zeevsklyar6-ai/RoboticArm/Code/Pics/WiringDiagram/Other/WieringModified.png

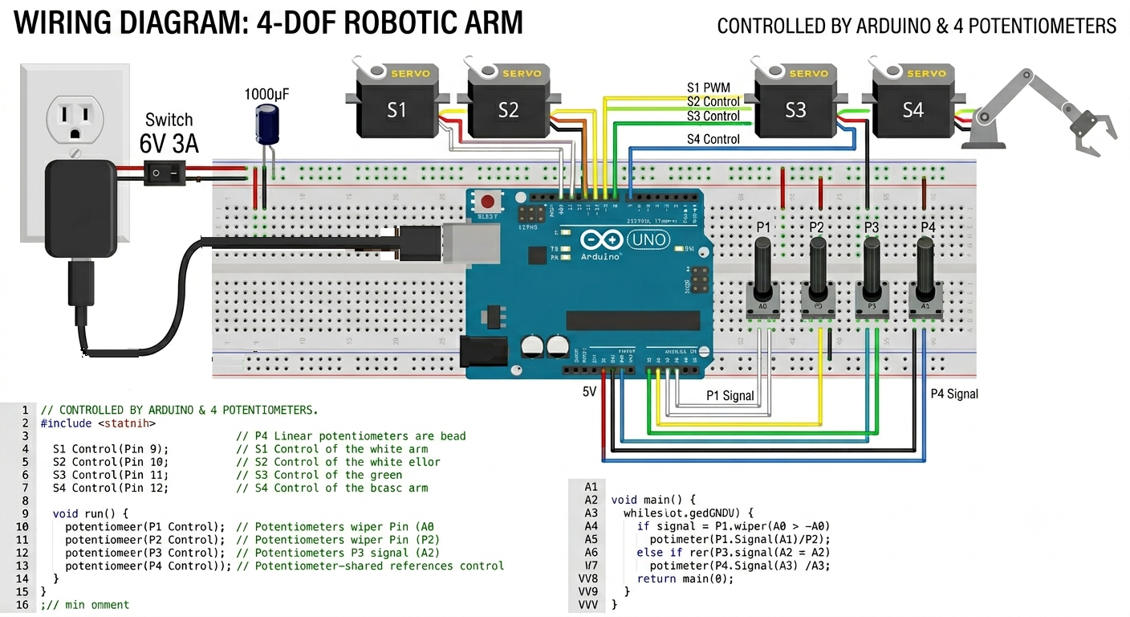
Code/Pics/WiringDiagram/Other/WieringModified.png
