zeevsklyar6-ai/RoboticArm/3dPrinter/V1/RoboticArmV1_1.jpg

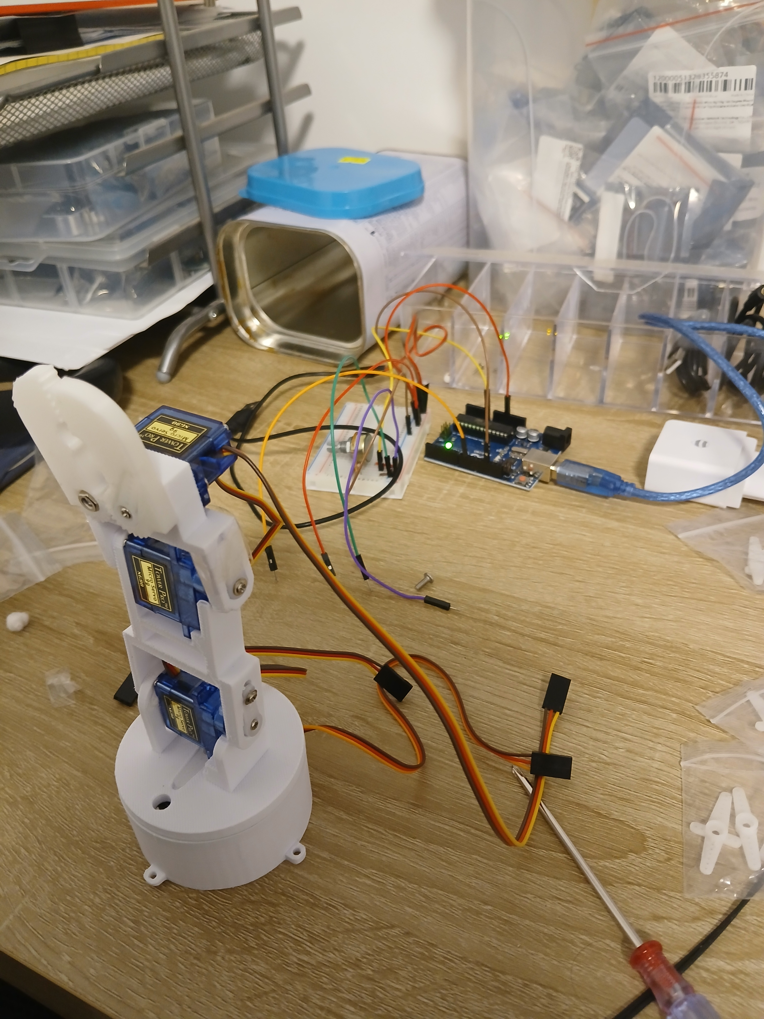
3dPrinter/V1/RoboticArmV1_1.jpg
