zeevsklyar6-ai/RoboticArm/Code/Pics/CamacitorsUsed.jpg

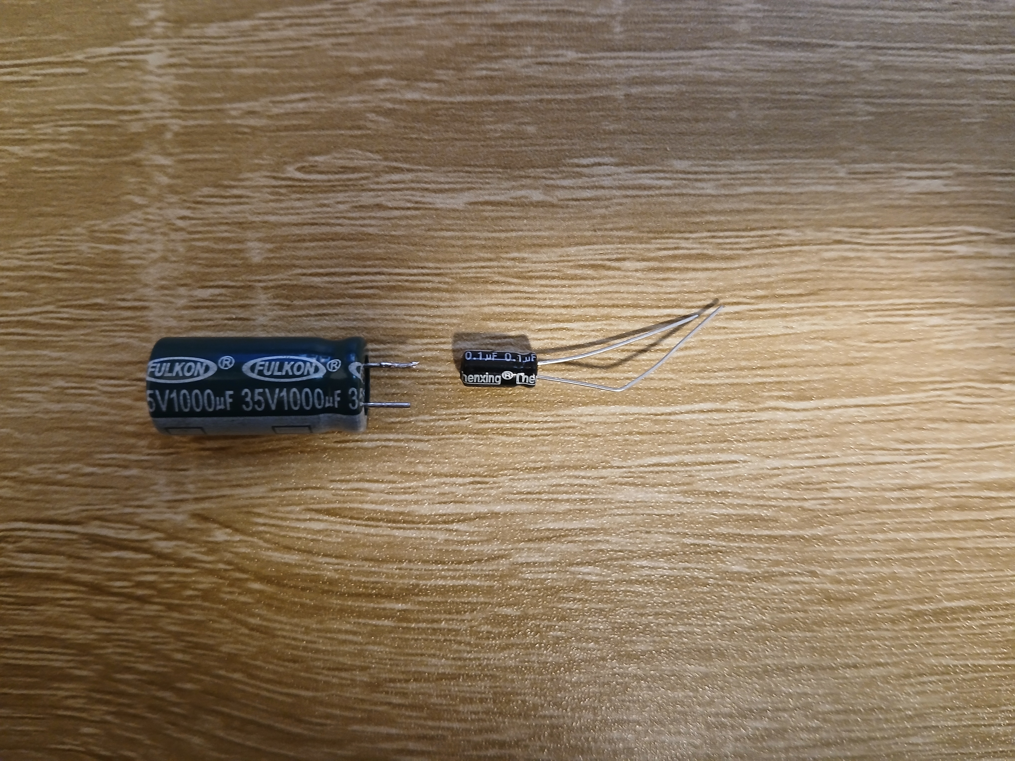
Code/Pics/CamacitorsUsed.jpg
