zeevsklyar6-ai/RoboticArm/Code/Pics/FinalConectionRoboticArmV1.jpg

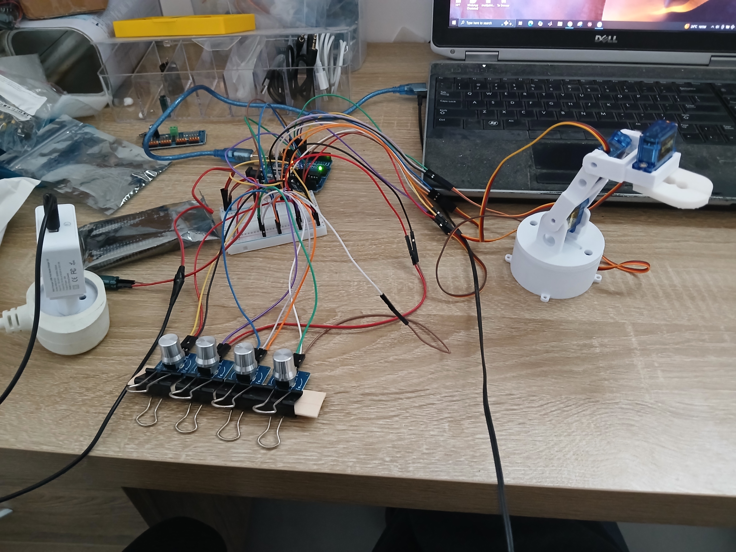
Code/Pics/FinalConectionRoboticArmV1.jpg
