zeevsklyar6-ai/RoboticArm/Code/PotenciometerControlsServoMotor/20260516_190331.jpg

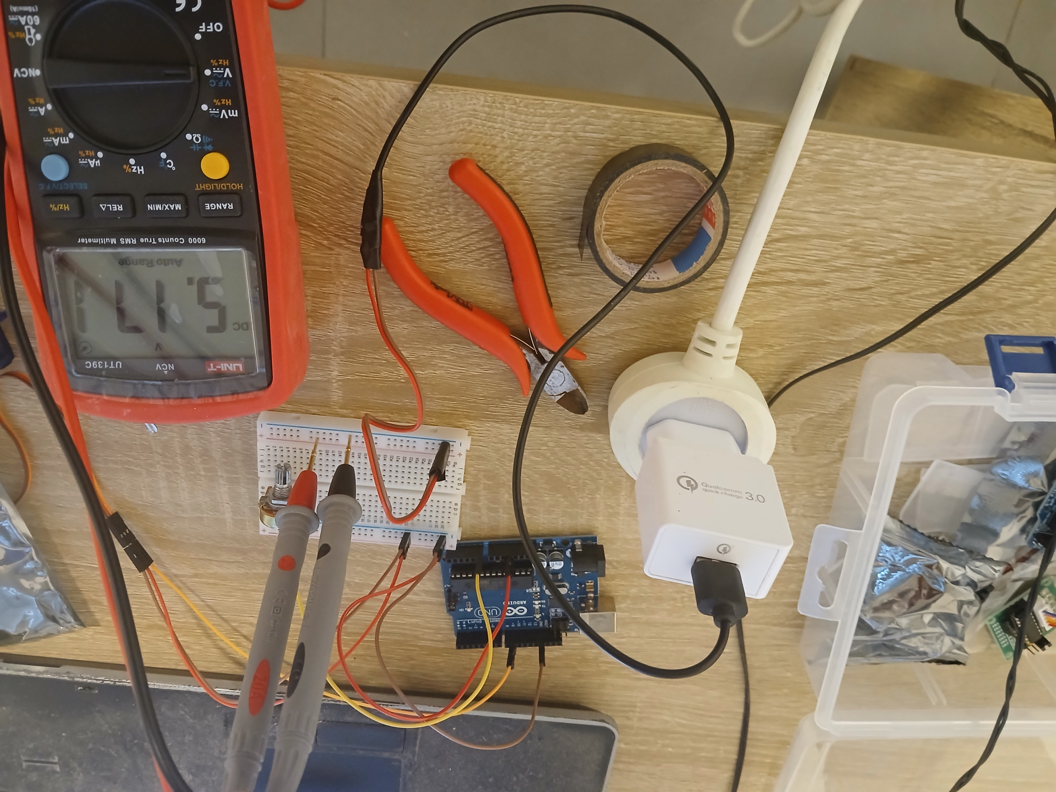
Code/PotenciometerControlsServoMotor/20260516_190331.jpg
