zeevsklyar6-ai/RoboticArm/Code/PotenciometerControlsServoMotor/20260516_194827.jpg

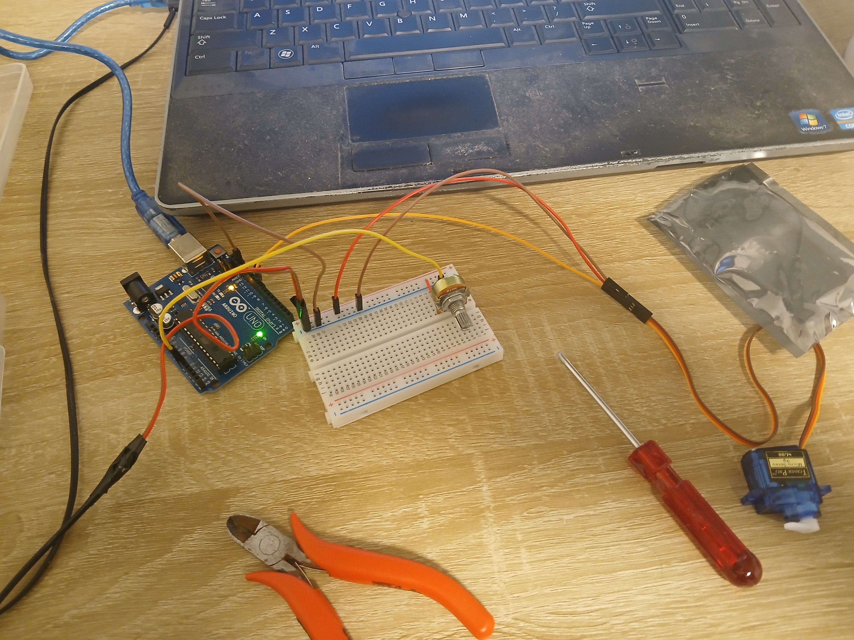
Code/PotenciometerControlsServoMotor/20260516_194827.jpg
