zeevsklyar6-ai/RoboticArm/Code/PotenciometerControlsServoMotor/PotenciometerControlsServoMotor.jpg

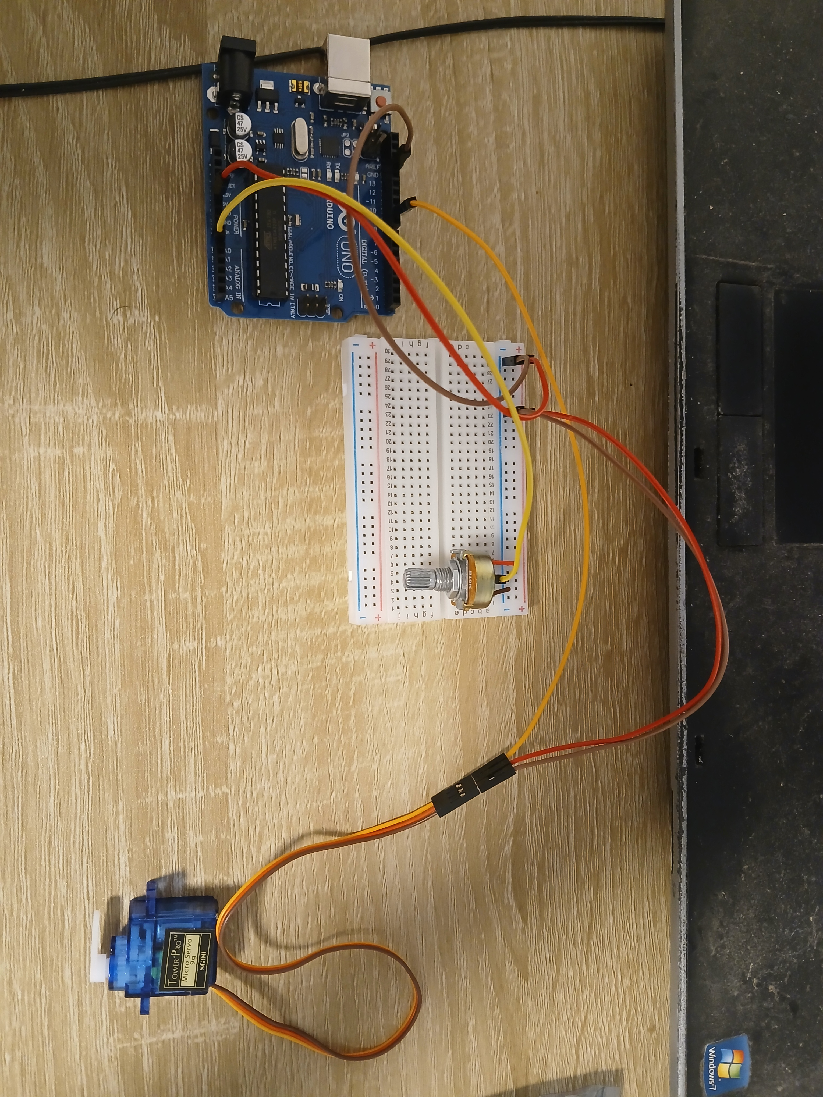
Code/PotenciometerControlsServoMotor/PotenciometerControlsServoMotor.jpg
