zeevsklyar6-ai/RoboticArm/3dPrinter/old/5/2print/Main_equation_hr_big_6810_REV0.stl

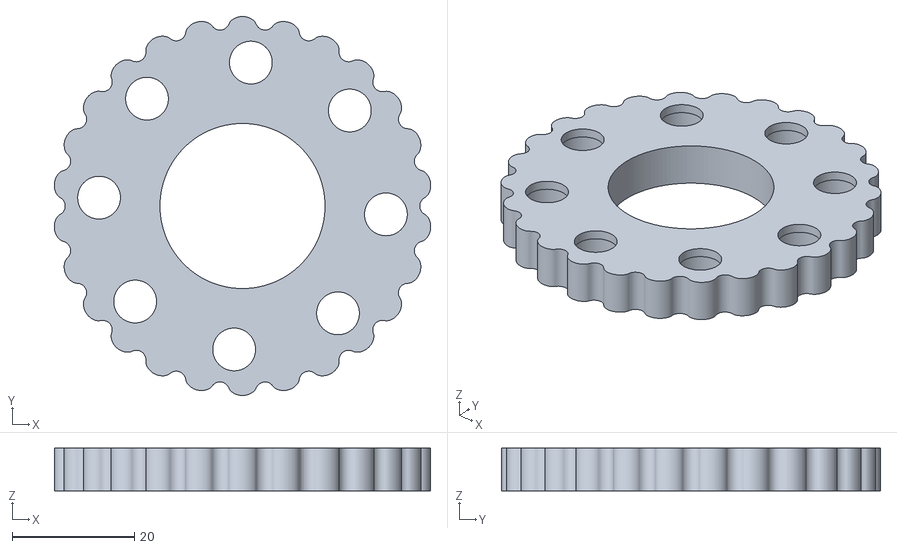
[picture p12: CAD file, 2026-06-20, an earlier design]
3dPrinter/old/5/2print/Main_equation_hr_big_6810_REV0.stl
61.6 x 62.0 x 7.00
