zeevsklyar6-ai/RoboticArm/3dPrinter/old/1/2print/Axis5Bracket.stl

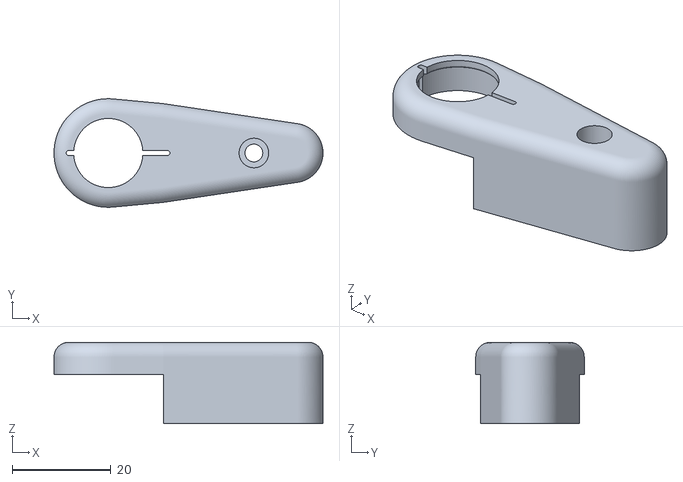
[picture p13: CAD file, 2026-06-20, an earlier design]
3dPrinter/old/1/2print/Axis5Bracket.stl
54.5 x 22.0 x 16.5
