zeevsklyar6-ai/RoboticArm/3dPrinter/old/4/uploads_files_79523_FrontPlate.stl

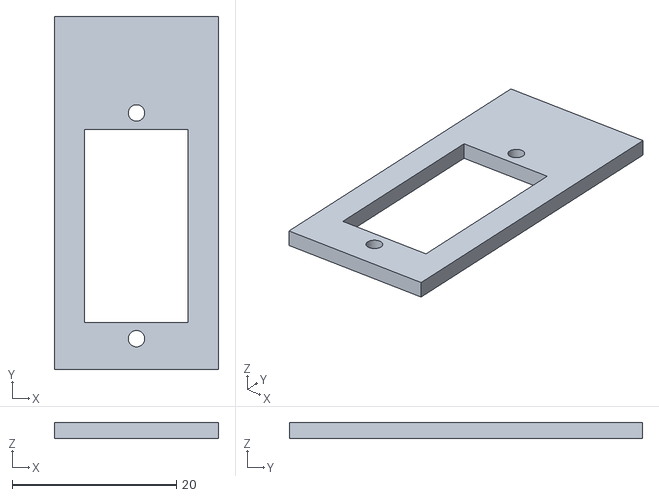
[picture p14: CAD file, 2026-06-20, an earlier design]
3dPrinter/old/4/uploads_files_79523_FrontPlate.stl
20.0 x 43.0 x 2.00
