zeevsklyar6-ai/RoboticArm/3dPrinter/old/5/2print/tri_base_6810_REV0.stl

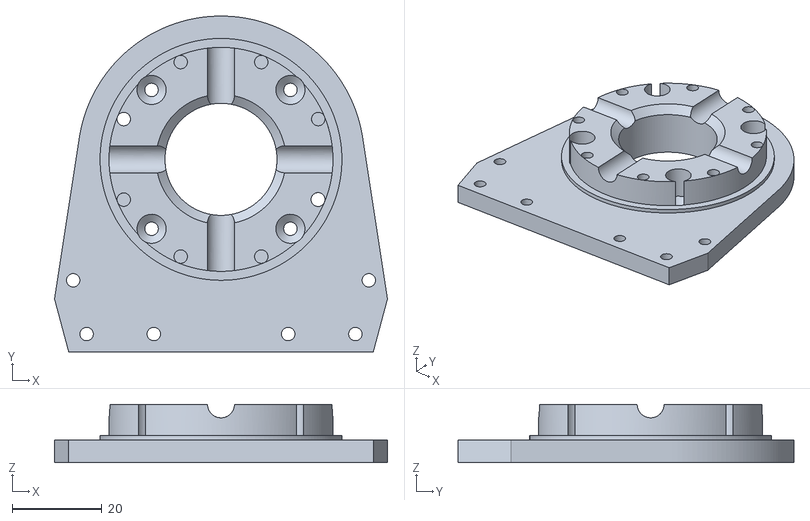
[picture p15: CAD file, 2026-06-20, an earlier design]
3dPrinter/old/5/2print/tri_base_6810_REV0.stl
74.4 x 75.0 x 13.0
