zeevsklyar6-ai/RoboticArm/3dPrinter/old/7/Roboteurs/grippy-bot/2print/MidArm.STL

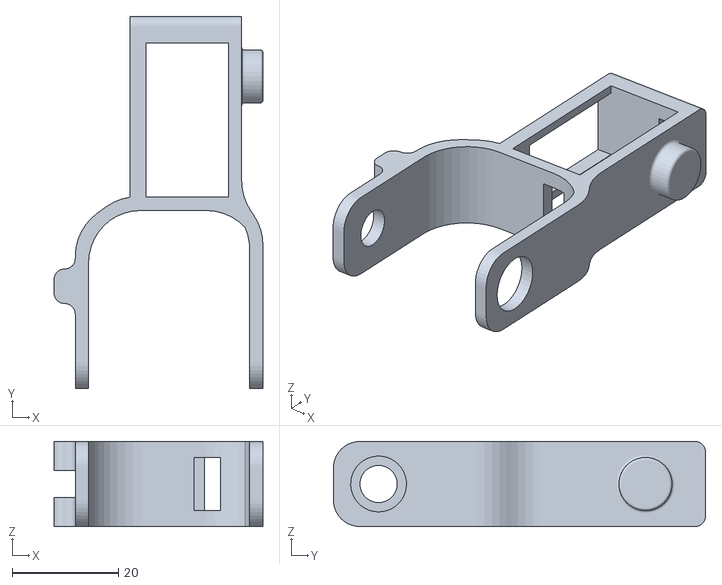
[picture p16: CAD file, 2026-06-20, an earlier design]
3dPrinter/old/7/Roboteurs/grippy-bot/2print/MidArm.STL
39.3 x 70.0 x 16.0
