zeevsklyar6-ai/RoboticArm/3dPrinter/old/7/Roboteurs/grippy-bot/Finger.STL

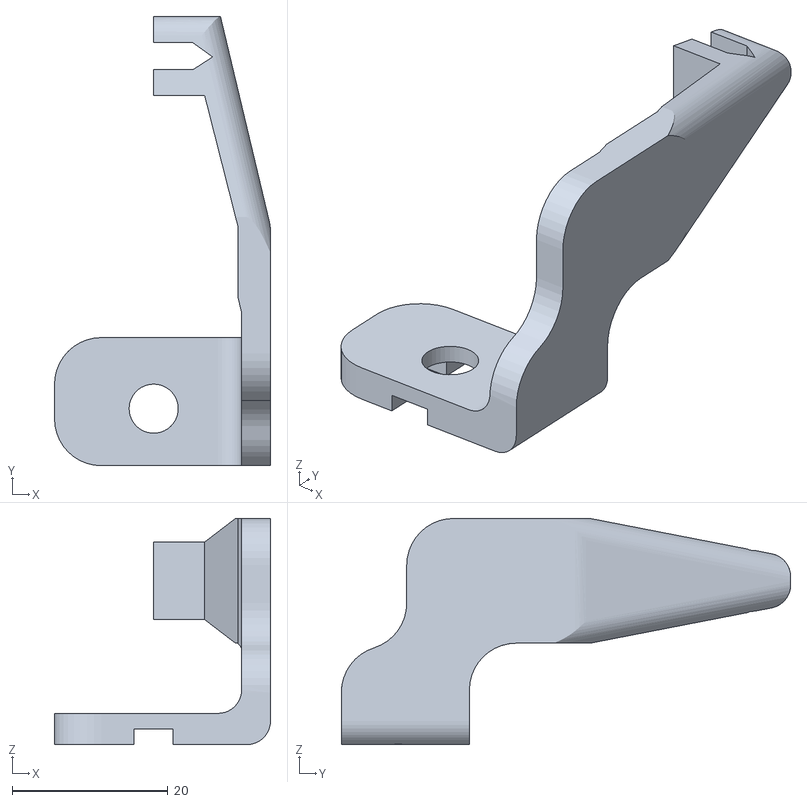
[picture p17: CAD file, 2026-06-20, an earlier design]
3dPrinter/old/7/Roboteurs/grippy-bot/Finger.STL
27.7 x 57.6 x 29.0
