zeevsklyar6-ai/RoboticArm/3dPrinter/old/1/2print/Axis3cover1.stl

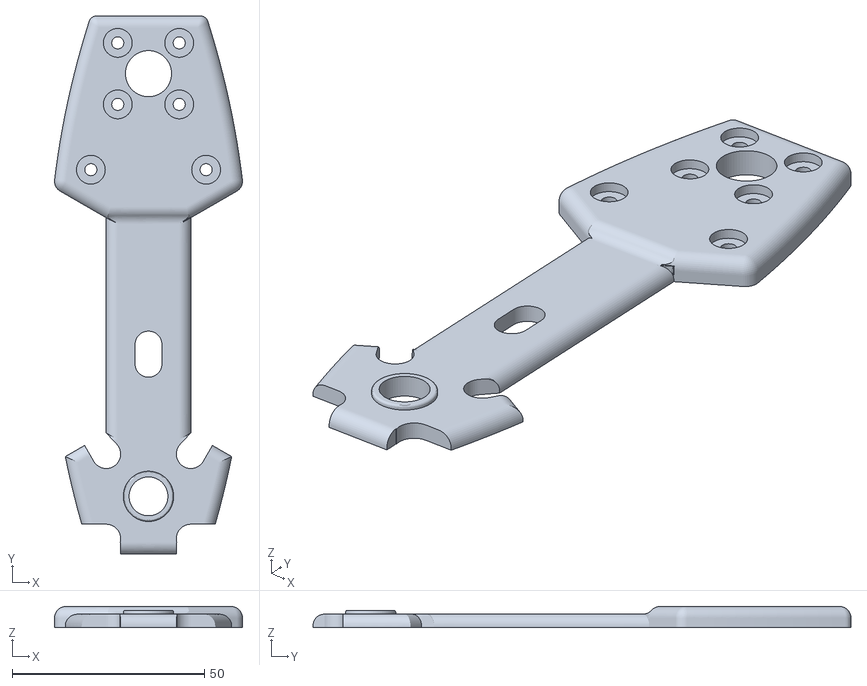
[picture p18: CAD file, 2026-06-20, an earlier design]
3dPrinter/old/1/2print/Axis3cover1.stl
48.9 x 140.0 x 5.50
