zeevsklyar6-ai/RoboticArm/3dPrinter/old/4/uploads_files_79523_GripperRack.stl

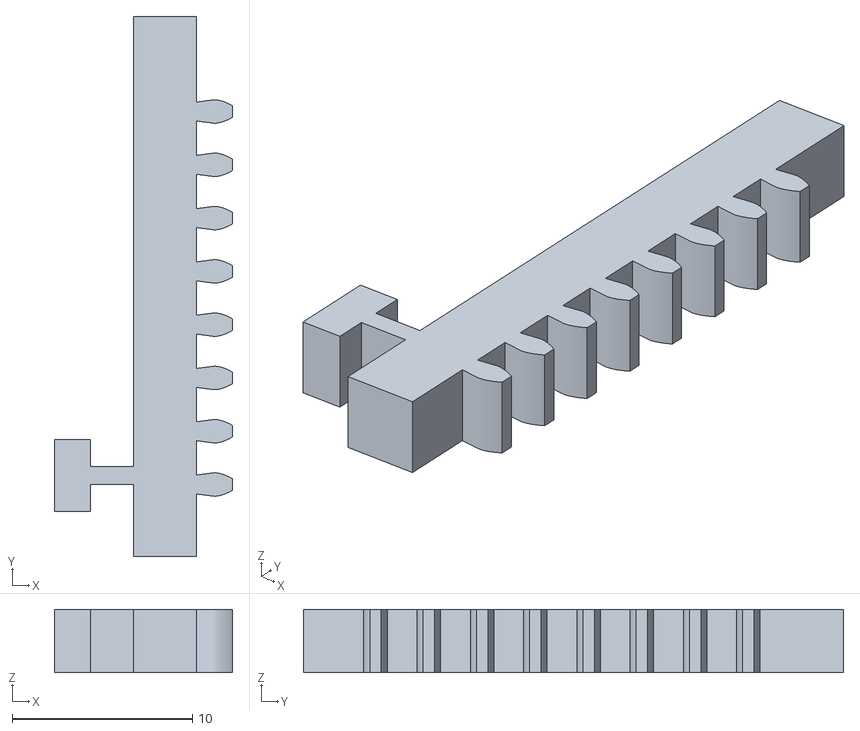
[picture p19: CAD file, 2026-06-20, an earlier design]
3dPrinter/old/4/uploads_files_79523_GripperRack.stl
9.89 x 30.0 x 3.50
