zeevsklyar6-ai/RoboticArm/3dPrinter/old/5/2print/eq_Outer_tri_body_6810_REV0.stl

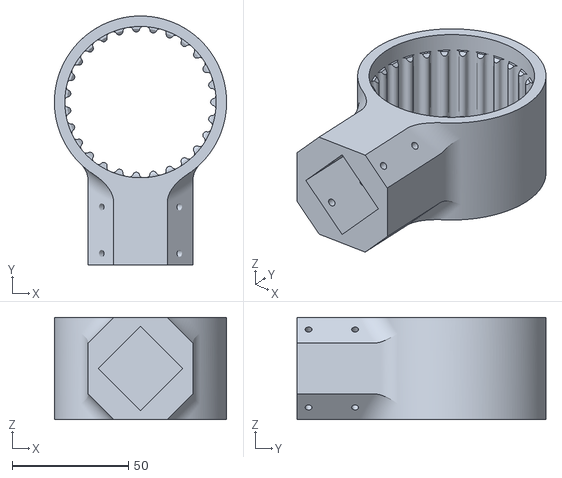
[picture p20: CAD file, 2026-06-20, an earlier design]
3dPrinter/old/5/2print/eq_Outer_tri_body_6810_REV0.stl
74.0 x 107.0 x 44.0
