zeevsklyar6-ai/RoboticArm/3dPrinter/old/7/Roboteurs/grippy-bot/2print/GripperArm.STL

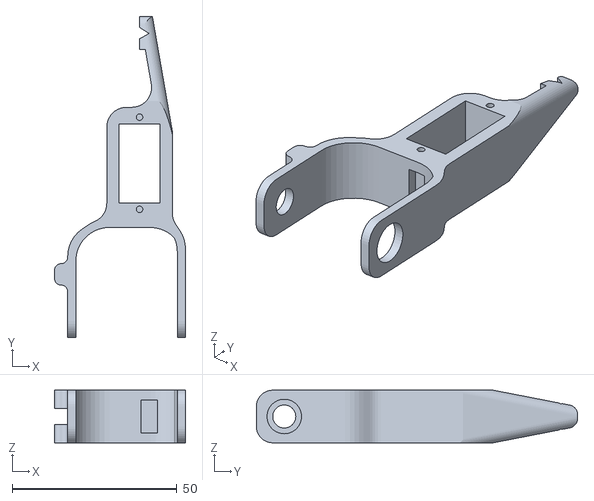
[picture p21: CAD file, 2026-06-20, an earlier design]
3dPrinter/old/7/Roboteurs/grippy-bot/2print/GripperArm.STL
39.8 x 97.6 x 16.0
