zeevsklyar6-ai/RoboticArm/3dPrinter/old/7/Roboteurs/grippy-bot/BaseSpin.STL

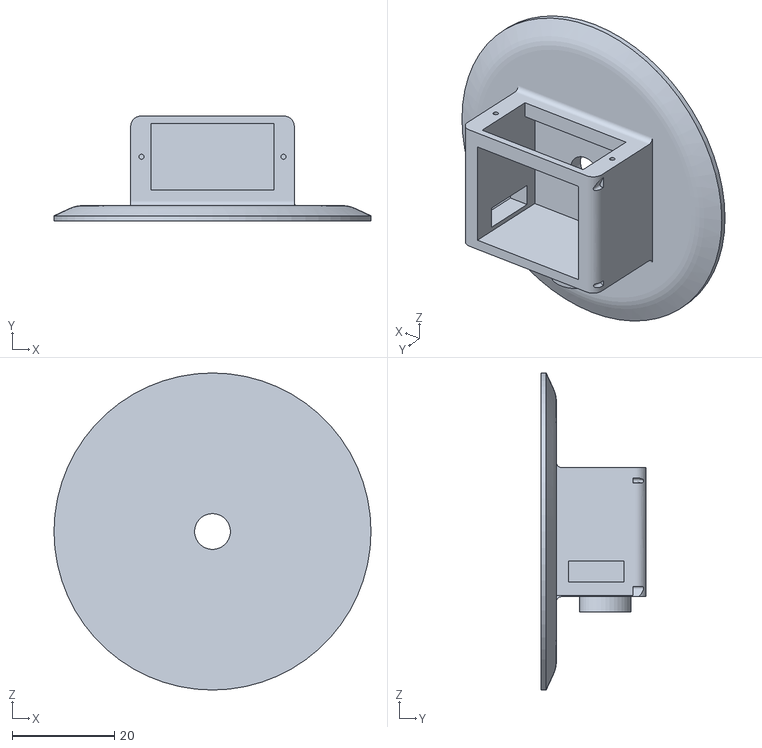
[picture p22: CAD file, 2026-06-20, an earlier design]
3dPrinter/old/7/Roboteurs/grippy-bot/BaseSpin.STL
62.0 x 20.5 x 62.0
