zeevsklyar6-ai/RoboticArm/3dPrinter/old/1/2print/Axis3part1.stl

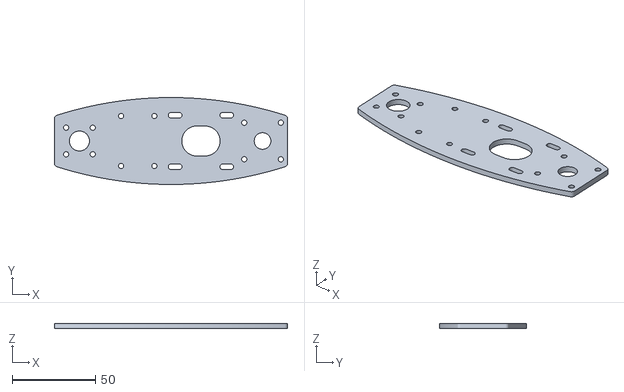
[picture p23: CAD file, 2026-06-20, an earlier design]
3dPrinter/old/1/2print/Axis3part1.stl
140.0 x 52.2 x 3.00
