zeevsklyar6-ai/RoboticArm/3dPrinter/old/4/uploads_files_79523_Swing (1).stl

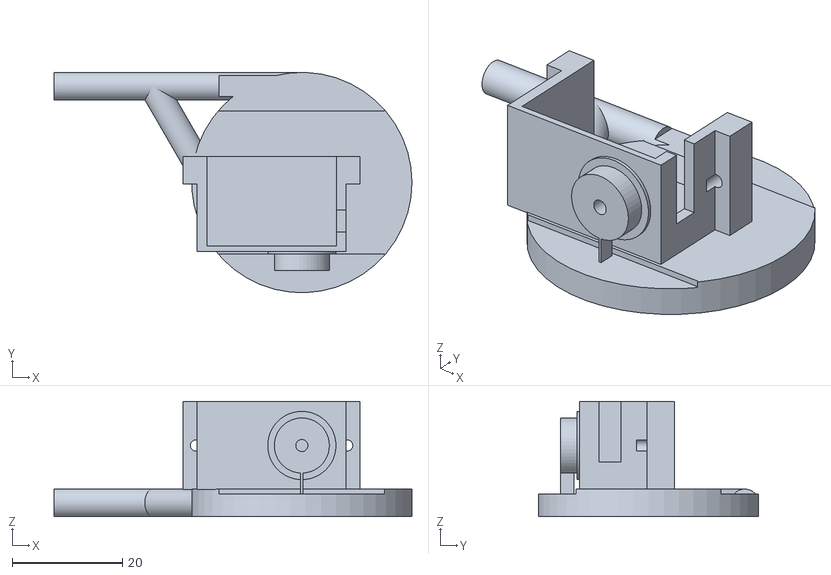
[picture p24: CAD file, 2026-06-20, an earlier design]
3dPrinter/old/4/uploads_files_79523_Swing (1).stl
65.0 x 40.0 x 20.9
