zeevsklyar6-ai/RoboticArm/3dPrinter/old/5/2print/tri_ecc_cam_REV0.stl

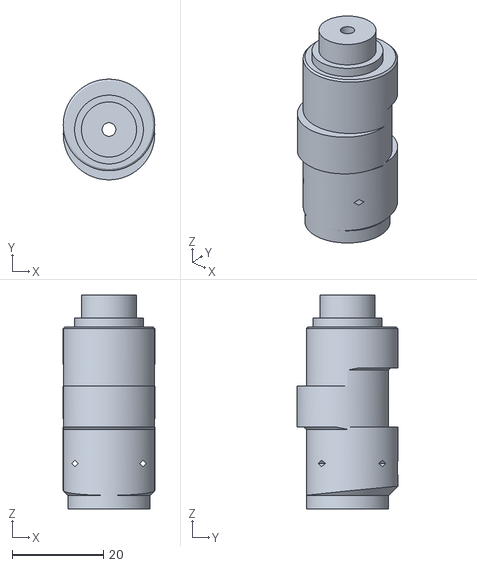
[picture p25: CAD file, 2026-06-20, an earlier design]
3dPrinter/old/5/2print/tri_ecc_cam_REV0.stl
20.1 x 22.1 x 47.0
