zeevsklyar6-ai/RoboticArm/3dPrinter/old/1/2print/Axis4limit.stl

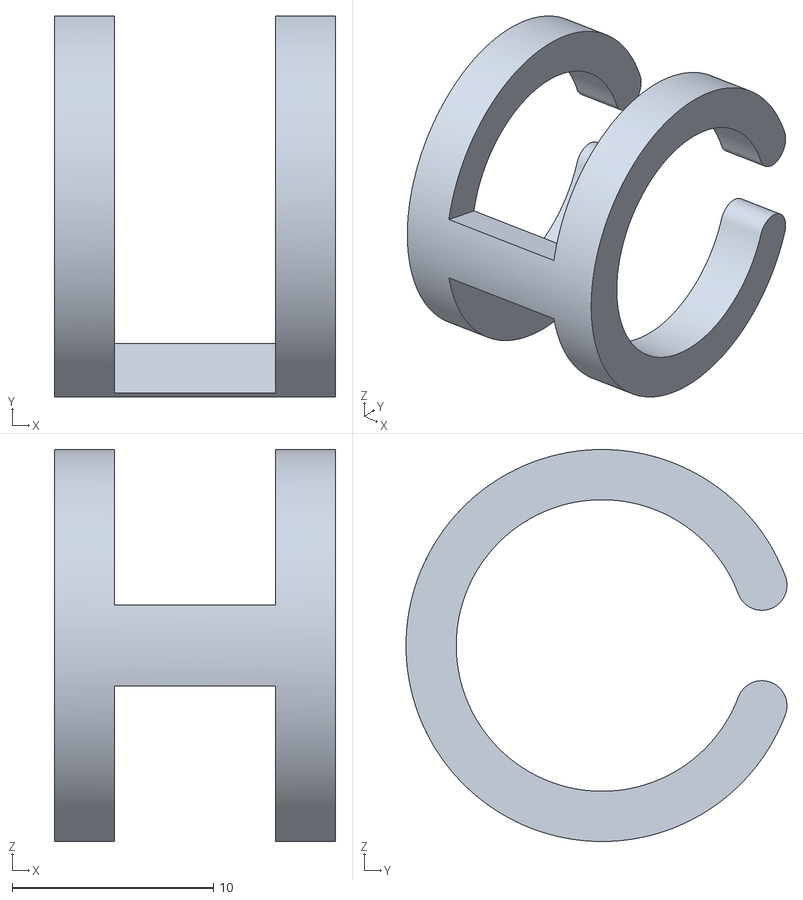
[picture p26: CAD file, 2026-06-20, an earlier design]
3dPrinter/old/1/2print/Axis4limit.stl
14.0 x 19.0 x 19.5
