zeevsklyar6-ai/RoboticArm/(list of files, cad)

Other CAD files:
3dPrinter/old/4/uploads_files_79523_RoboArm.scad
3dPrinter/old/1/2print/Axis1MotorHolder.stl
3dPrinter/old/1/2print/Axis1Pulley.stl
3dPrinter/old/1/2print/Axis1part2.stl
3dPrinter/old/1/2print/Axis1washer.stl
3dPrinter/old/1/2print/Axis2MotorOpC.stl
3dPrinter/old/1/2print/Axis2Pulley.stl
3dPrinter/old/1/2print/Axis2bearingHC.stl
3dPrinter/old/1/2print/Axis2part2.stl
3dPrinter/old/1/2print/Axis3cover2.stl
3dPrinter/old/1/2print/Axis3part2.stl
3dPrinter/old/1/2print/Axis3part3.stl
3dPrinter/old/1/2print/Axis4.stl
3dPrinter/old/1/2print/Axis5.stl
3dPrinter/old/1/2print/Axis5plug.stl
3dPrinter/old/1/2print/Axis5screwHolder.stl
3dPrinter/old/1/2print/Axis6.stl
3dPrinter/old/1/2print/Cover.stl
3dPrinter/old/1/2print/Electronics.stl
3dPrinter/old/1/2print/FootHolder.stl
3dPrinter/old/1/2print/LegLeft.stl
3dPrinter/old/1/2print/Pulley100.stl
3dPrinter/old/1/2print/Pulley42.stl
3dPrinter/old/1/2print/Pulley56.stl
3dPrinter/old/1/2print/axis6motorHolder.stl
3dPrinter/old/4/uploads_files_79523_Arm.stl
3dPrinter/old/4/uploads_files_79523_ArmFront.stl
3dPrinter/old/4/uploads_files_79523_ArmSpring.stl
3dPrinter/old/4/uploads_files_79523_Foot.stl
3dPrinter/old/4/uploads_files_79523_Gripper.stl
3dPrinter/old/4/uploads_files_79523_GripperGear.stl
3dPrinter/old/5/2print/tri_base_free_6810_REV0.stl
3dPrinter/old/5/2print/tri_sholder_top_base_lite_part_A_REV0.stl
3dPrinter/old/7/Roboteurs/grippy-bot/2print/BaseArm.STL
3dPrinter/old/7/Roboteurs/grippy-bot/Base.STL
3dPrinter/old/7/Roboteurs/grippy-bot/BaseArm.STL
