zeevsklyar6-ai/RoboticArm/3dPrinter/V1/Link.txt

https://he.aliexpress.com/item/1005006199119777.html
