zeevsklyar6-ai/RoboticArm/3dPrinter/V1/RoboticArmV1_2.jpg

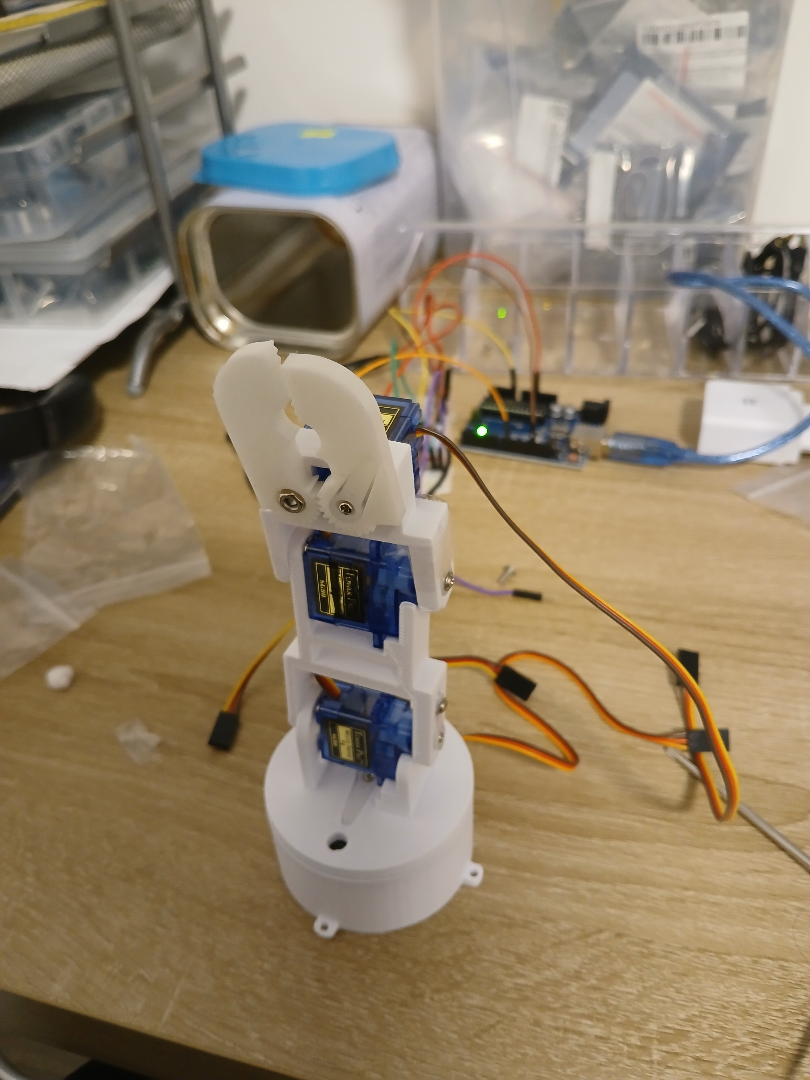
3dPrinter/V1/RoboticArmV1_2.jpg
