zeevsklyar6-ai/RoboticArm/Code/Pics/WiringDiagram/FinalWiringDiff.PNG

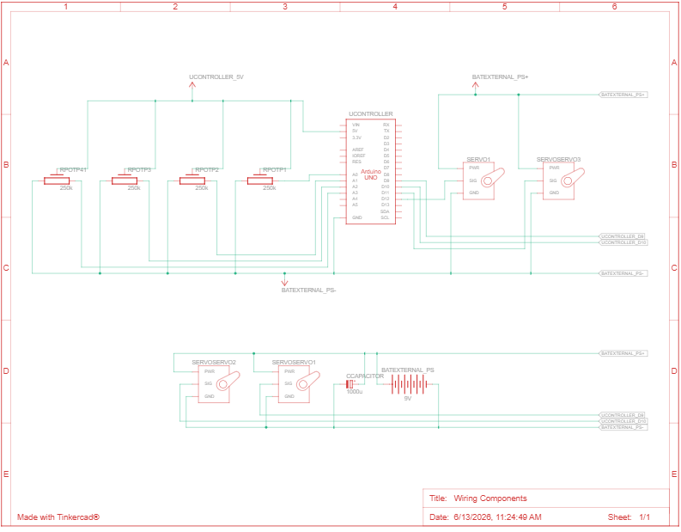
Code/Pics/WiringDiagram/FinalWiringDiff.PNG
