zeevsklyar6-ai/RoboticArm/Code/Pics/WiringDiagram/eea5ed88-44b6-4536-a725-5f70513bd69a.pdf

A

1 | 2 | 3 | 4 | 5 | 6

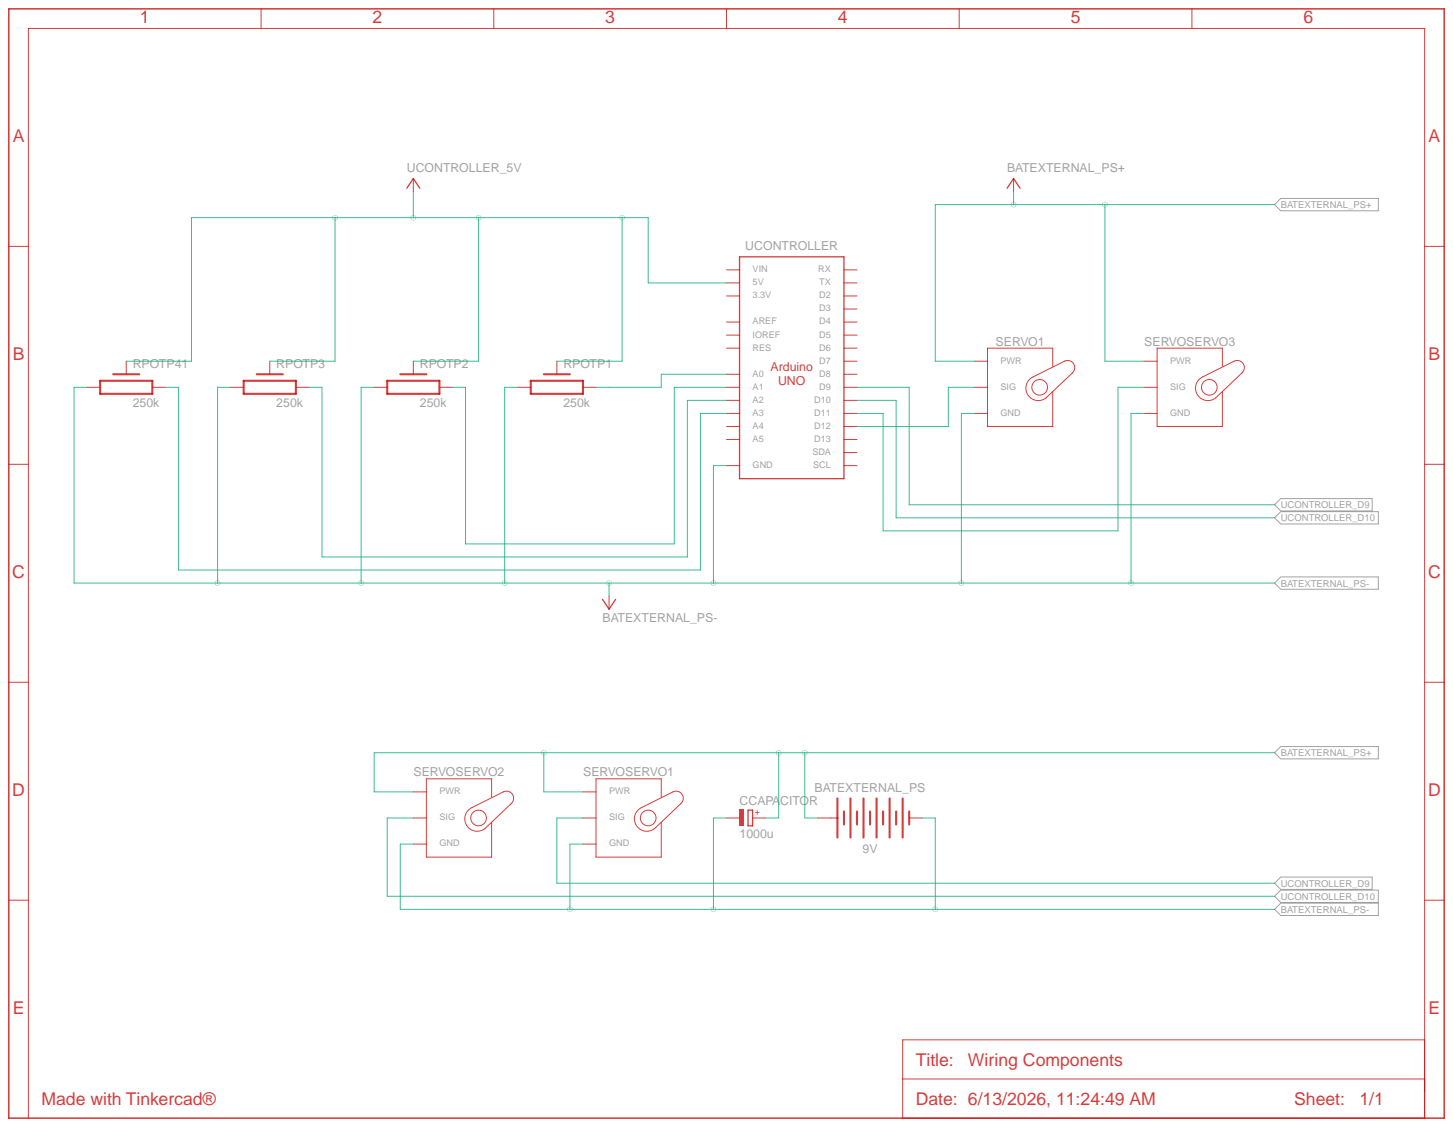
[picture p29: page 1]
